fardinanam/Laser-Security-System-With-Arduino/alarm_unit/laser_security_system.ino

#define LED 13
#define STOPBUTTON 4
#define LDRIN 3
#define LDRIN2 2
#define MILLISPERBIT 200
#define LDR_SWITCH_1 5
#define LDR_SWITCH_2 6

#include <GPRS_Shield_Arduino.h>
#include <SoftwareSerial.h>
#include <Wire.h>
//#include <GSM.h>

#define PIN_TX    7
#define PIN_RX    8
#define BAUDRATE  9600
#define PHONE_NUMBER  "XXXXXXXXXXX" // Use the owner's phone number
#define MESSAGE "Breach of boundary detected."

GPRS gprs(PIN_TX, PIN_RX, BAUDRATE); //RX,TX,PWR,BaudRate

long int lastChangeTimeOfLdr1;
long int lastChangeTimeOfLdr2;
bool buttonPressed;
bool sensor_button_on_1 = true;
bool sensor_button_on_2 = true;

void ldr1Interrupt() {
//  Serial.println("ldr changed");
  Serial.println(millis() - lastChangeTimeOfLdr1);
  lastChangeTimeOfLdr1 = millis(); 
}

void ldr2Interrupt() {
  // Serial.println(millis() - lastChangeTimeOfLdr2);
  lastChangeTimeOfLdr2 = millis(); 
}

void buttonInterrupt() {
  buttonPressed = true;
//  Serial.println("Button pressed");
}

void alarm() {
  Serial.println("Sending SMS...");
  gprs.sendSMS(PHONE_NUMBER, MESSAGE);
  Serial.println("start to call ...");
  gprs.callUp(PHONE_NUMBER);
  
  int ledState = 1;
  // start to blink the alarm
  while(!digitalRead(STOPBUTTON)) {
    digitalWrite(LED, ledState);
    delay(500);
    ledState = !ledState;
  }
  // stop the alarm when the button is pressed
  // Serial.println("alarm should turn off now");
  digitalWrite(LED, 0);
  buttonPressed = false;
  lastChangeTimeOfLdr1 = millis();
  lastChangeTimeOfLdr2 = millis();
}

void setup() {
  gprs.checkPowerUp();
  Serial.begin(9600);
  while (!gprs.init()) {
      delay(1000);
      Serial.println("Initialization failed!");
  }

  while (!gprs.isNetworkRegistered()) {
      delay(1000);
      Serial.println("Network has not registered yet!");
  }
  
  Serial.begin(9600);
  pinMode(LED, OUTPUT);
  pinMode(LDR_SWITCH_1 , INPUT);
  pinMode(LDR_SWITCH_1 , INPUT);
  
  // enabling pins for interrupt
//  pciSetup(15);
  attachInterrupt(digitalPinToInterrupt(LDRIN), ldr1Interrupt, CHANGE);
  attachInterrupt(digitalPinToInterrupt(LDRIN2), ldr2Interrupt, CHANGE);
//  attachInterrupt(digitalPinToInterrupt(STOPBUTTON), buttonInterrupt,RISING);
  lastChangeTimeOfLdr1 = millis();
  lastChangeTimeOfLdr2 = millis();
  buttonPressed = false;
  
}



void loop() {
  long int timeElapsed1 = (millis() - lastChangeTimeOfLdr1);
  long int timeElapsed2 = (millis() - lastChangeTimeOfLdr2);
//  if(timeElapsed1 >= 300 || timeElapsed2 >= 300) Serial.println("WHY----------------");
  if((digitalRead(LDR_SWITCH_1) && (timeElapsed1 > (MILLISPERBIT + 100))) || (digitalRead(LDR_SWITCH_2) && (timeElapsed2 > (MILLISPERBIT + 100)))) {
    alarm();
  }
  //sensor_button_on_1
  //if(digitalRead(LDR_SWITCH_1)) sensor_button_on_1=!sensor_button_on_1;
  //if(digitalRead(LDR_SWITCH_2)) sensor_button_on_2=!sensor_button_on_2;
}
